AllenNeuralDynamics/harp.device.PhotodiodeBoard/hardware/board/0374 Production Board/0374 Production Board.csv

Reference | Qty | Footprint | Value | Manufacturer | Manufacturer Number | DNP
C1,C2,C6,C8,C13,C14,C15,C16,C17,C18,C19,C20,C25,C28,C29 | 15 | Capacitor_SMD:C_0402_1005Metric | 100nF | Walson Technology Corporation | 0402B104K160CT
C3,C5 | 2 | Capacitor_SMD:C_0805_2012Metric_Pad1.18x1.45mm_HandSolder | 10pF | KEMET | C0805C100J5RACTU
C4,C21 | 2 | Capacitor_SMD:C_0402_1005Metric | 10nF | Murata Electronics | GRM1555C1E103GE01D
C9,C10,C11,C22 | 4 | Capacitor_SMD:C_0402_1005Metric | 1uF | KYOCERA AVX | KAM05CR71A105KH
C12 | 1 | Capacitor_SMD:C_0805_2012Metric | 10uF | Cal-Chip Electronics, Inc. | GMC21X7R106K25NT
C23 | 1 | Capacitor_SMD:C_0402_1005Metric | 2.2uF | Cal-Chip Electronics, Inc. | GMC04X7R225K10NT
CR1,CR2 | 2 | 0374Library:TO99_BPW20RF_VIS | BPW21R | Vishay Semiconductor Opto Division | BPW21R | DNP
D1,D2 | 2 | Diode_SMD:D_0201_0603Metric | D_TVS | onsemi | ESD8472MUT5G
D3,D4 | 2 | LED_SMD:LED_0603_1608Metric_Pad1.05x0.95mm_HandSolder | LED | SunLED | XZCDGK53W-1VF
D5 | 1 | Diode_SMD:D_SOD-323F | BAT54J | MCC (Micro Commercial Components) | BAT54WS-TP
H1,H2,H3,H4 | 4 | MountingHole:MountingHole_3.2mm_M3_DIN965 | MountingHole
H5,H6 | 2 | MountingHole:MountingHole_2.2mm_M2_DIN965 | MountingHole
J1 | 1 | 0374Library:Connector_3M_MiniClamp_4_37204-1BE0-004PL | Conn_01x04_Pin | 3M | 37204-1BE0-004 PL
J2 | 1 | 0374Library:CUI_SJ-3524-SMT-BE | AudioJack3 |  | SJ-3523-SMT-TR
J3 | 1 | Connector_USB:USB_C_Receptacle_JAE_DX07S016JA1R1500 | USB_C_Receptacle_USB2.0 | JAE Electronics | DX07S016JA1R1500
J4,J5 | 2 | Connector_PinHeader_2.54mm:PinHeader_1x03_P2.54mm_Vertical | ~
R1 | 1 | Resistor_SMD:R_0402_1005Metric | 1K | Yageo | AC0402FR-131KL
R2,R3 | 2 | Resistor_SMD:R_0402_1005Metric | 5K1 | Yageo | RT0402FRE075K1L
R4 | 1 | Resistor_SMD:R_0402_1005Metric | 487 | Vishay Dale | CRCW0402487RFKED
R5 | 1 | Resistor_SMD:R_0402_1005Metric | 4.7k | YAGEO | RC0402JR-074K7L
R6,R7 | 2 | Resistor_SMD:R_0805_2012Metric_Pad1.20x1.40mm_HandSolder | 390k
R8 | 1 | Resistor_SMD:R_0402_1005Metric | 10K | KOA Speer Electronics, Inc. | SG73P1EWTTP1002F
R9,R10 | 2 | Resistor_SMD:R_0402_1005Metric | 27 | Yageo | RC0402FR-0727RL
R11,R12 | 2 | Resistor_SMD:R_0402_1005Metric | 330 | Panasonic Electronic Components | ERA-2AEB331X
SW2 | 1 | 0374Library:435451019820 | ~ | Würth Elektronik | 435451019820
TP1,TP2,TP3 | 3 | TestPoint:TestPoint_Loop_D2.50mm_Drill1.0mm | TestPoint
U1 | 1 | Package_TO_SOT_SMD:Texas_DRT-3 | TPD2EUSB30 | Texas Instruments | TPD2EUSB30DRTR
U2 | 1 | Package_TO_SOT_SMD:SOT-23-5 | LP2985-3.3 | Texas Instruments | LP2985-33DBVR
U3 | 1 | 0374Library:QFN56_7X7_RPI | RP2040 | Raspberry Pi | SC0914(13)
U4 | 1 | 0374Library:USON-8_UX_2x3x0p6_WIN | W25Q16JVUXIQ | Winbond Electronics | W25Q16JVUXIQ TR
U5 | 1 | 0374Library:R_8_ADI | AD8656 | Analog Devices Inc. | AD8656ARZ-REEL
U6 | 1 | 0374Library:DDC0005A_M | REF2033AIDDCR | Texas Instruments | REF2033AIDDCR
U7 | 1 | Package_SO:MFSOP6-4_4.4x3.6mm_P1.27mm | Optocoupler_DC_PhotoNPN_AKEC | Lite-On Inc. | LTV-356T
X1 | 1 | Crystal:Crystal_SMD_2016-4Pin_2.0x1.6mm | ECS-TXO-2016 | ECS Inc. | ECS-TXO-2016-33-120-TR
