AllenNeuralDynamics/harp.device.PhotodiodeBoard/hardware/board/Footprint and Symbols/AD8656ARZ_REEL/R_8_ADI.step

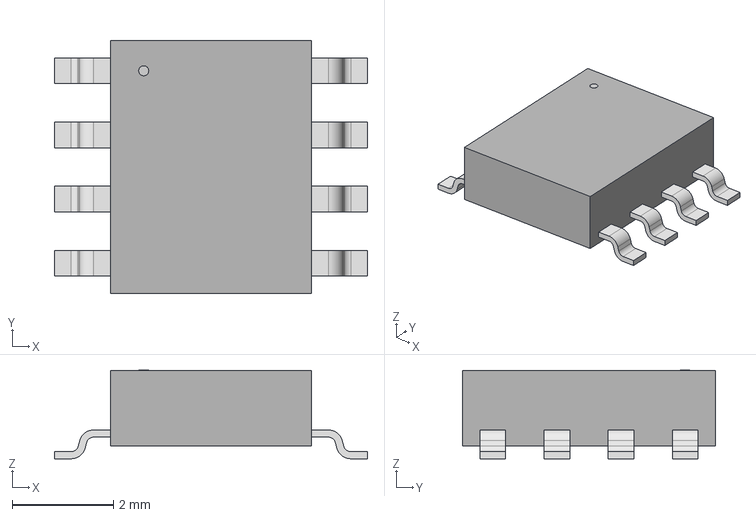
[picture p1: CAD file, 2026-10-02]
hardware/board/Footprint and Symbols/AD8656ARZ_REEL/R_8_ADI.step
6.20 x 5.00 x 1.75 mm
