AllenNeuralDynamics/harp.device.PhotodiodeBoard/hardware/board/Footprint and Symbols/BPW21R/TO99_BPW20RF_VIS.step

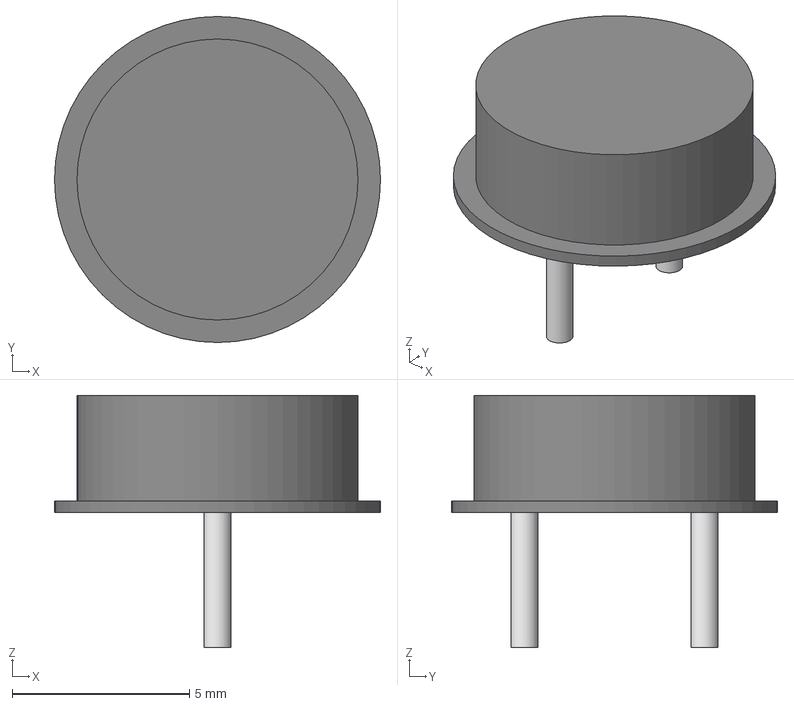
[picture p2: CAD file, 2026-10-02]
hardware/board/Footprint and Symbols/BPW21R/TO99_BPW20RF_VIS.step
9.19 x 9.19 x 7.11 mm
