AllenNeuralDynamics/harp.device.PhotodiodeBoard/hardware/board/Footprint and Symbols/SC0914_13_/QFN56_7X7_RPI.step

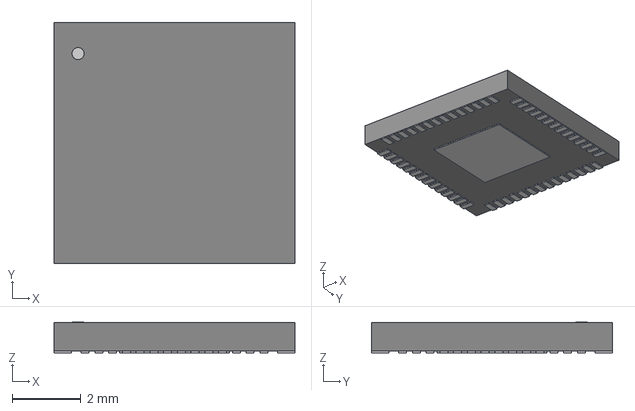
[picture p3: CAD file, 2026-10-02]
hardware/board/Footprint and Symbols/SC0914_13_/QFN56_7X7_RPI.step
7.01 x 7.01 x 0.892 mm
