AllenNeuralDynamics/harp.device.PhotodiodeBoard/hardware/board/Footprint and Symbols/SJ-3524-SMT-BE/SJ-3524-SMT-BE.step

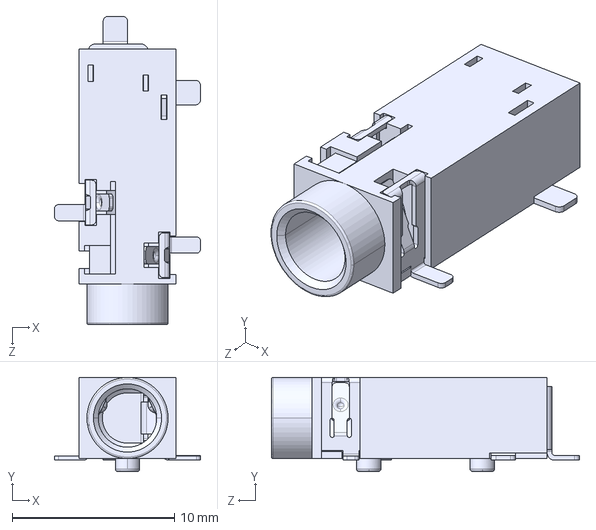
[picture p4: CAD file, 2026-10-02]
hardware/board/Footprint and Symbols/SJ-3524-SMT-BE/SJ-3524-SMT-BE.step
9.00 x 5.80 x 19.0 mm
