AllenNeuralDynamics/harp.device.PhotodiodeBoard/hardware/board/Footprint and Symbols/W25Q16JVUXIQ_TR/USON-8_UX_2x3x0p6_WIN.step

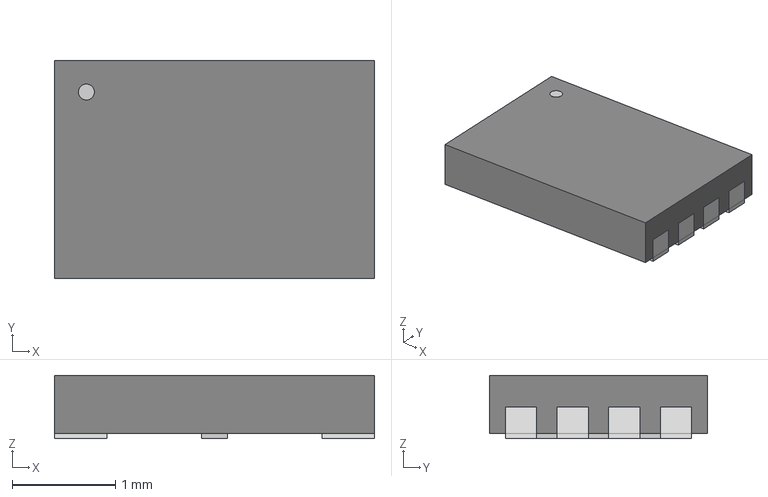
[picture p5: CAD file, 2026-10-02]
hardware/board/Footprint and Symbols/W25Q16JVUXIQ_TR/USON-8_UX_2x3x0p6_WIN.step
3.10 x 2.11 x 0.612 mm
