AllenNeuralDynamics/harp.device.PhotodiodeBoard/(list of files, cad)

Other CAD files:
hardware/board/Footprint and Symbols/435451019820/435451019820.step
