AllenNeuralDynamics/harp.device.PhotodiodeBoard/hardware/board/0374 Production Board/0374 Production Board.kicad_pcb

## KiCad design hardware/board/0374 Production Board/0374 Production Board.kicad_pcb (2026-10-02)

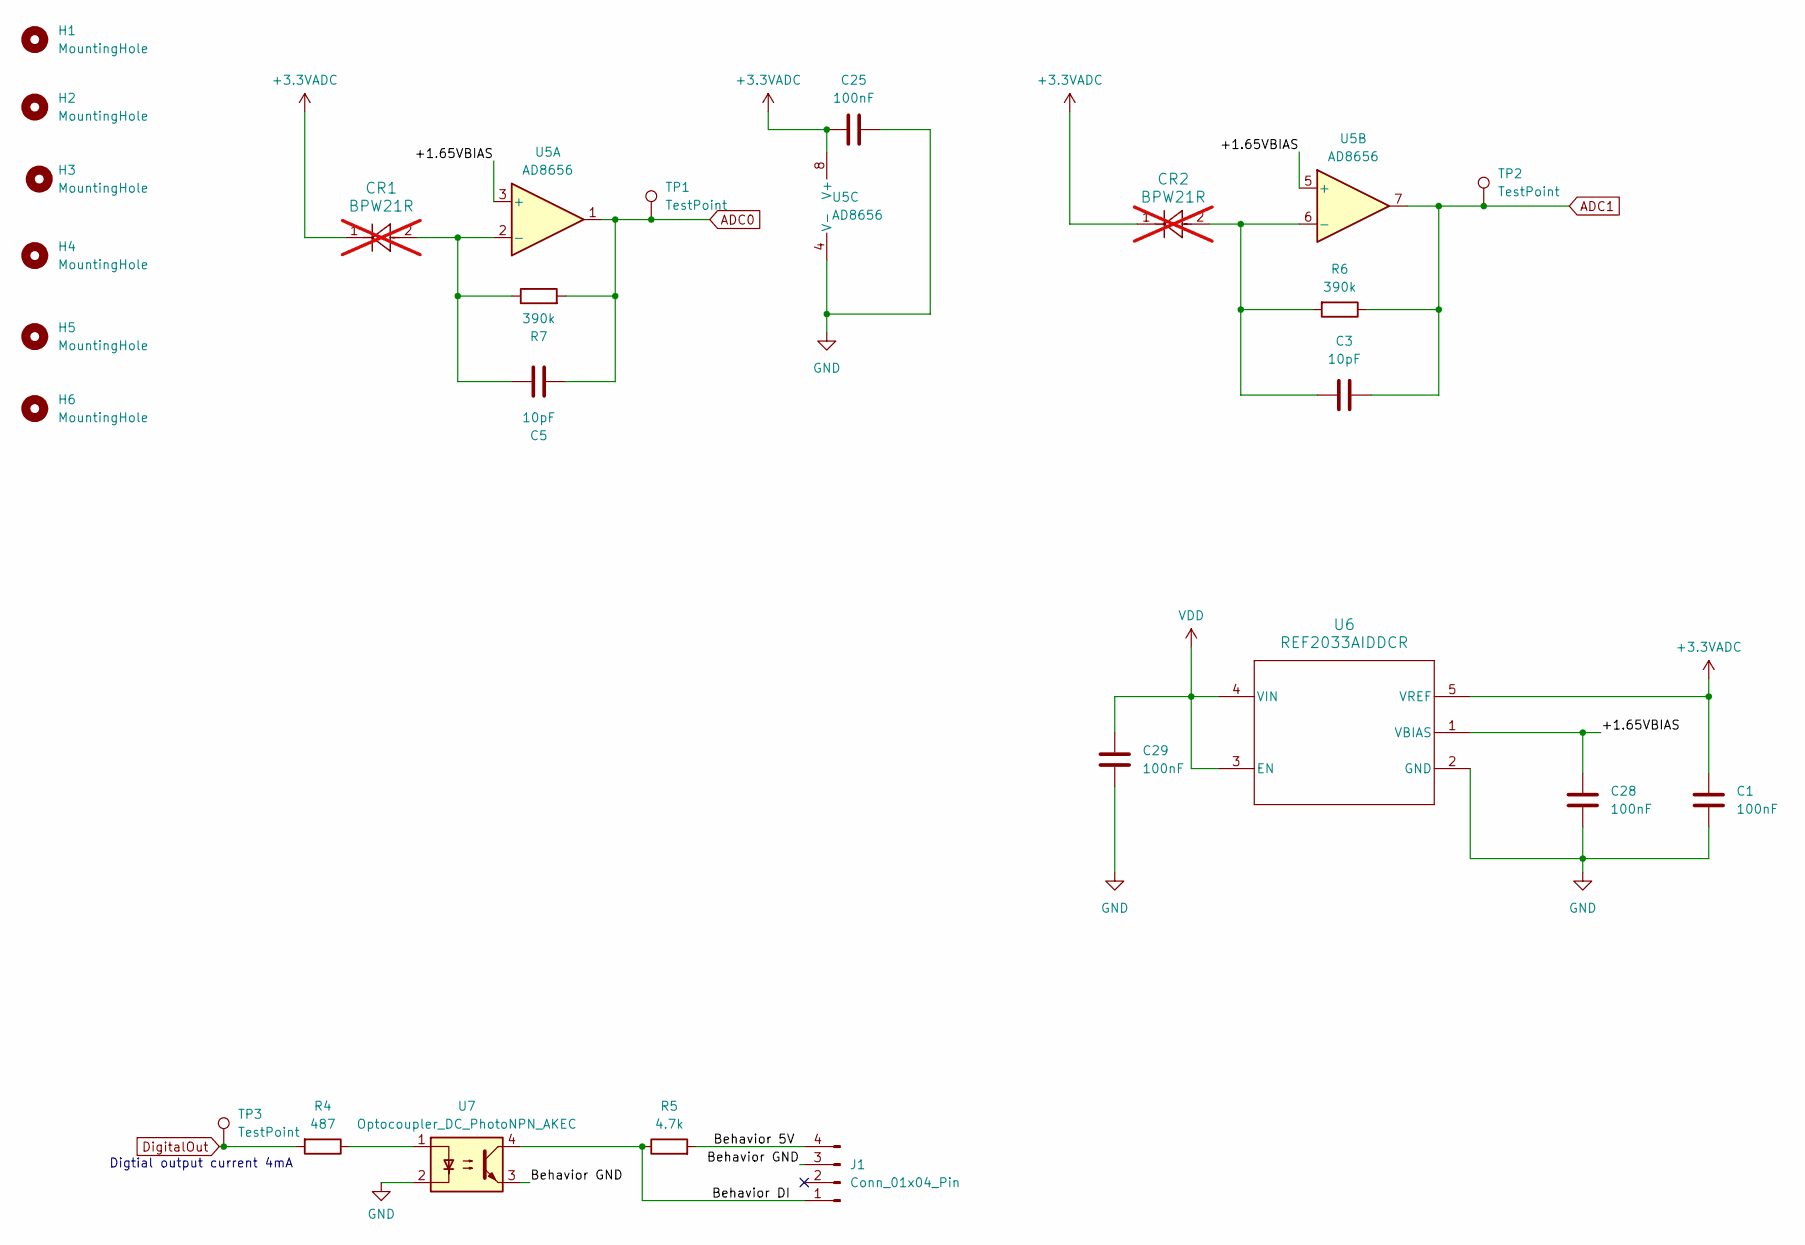
[picture p6: schematic 0374_Photodiode.kicad_sch]

Parts:
C1, C25, C28, C29: 100nF; C_0402_1005Metric; Rated Voltage 16V; Tolerance 10%
C3, C5: 10pF; C_0805_2012Metric_Pad1.18x1.45mm_HandSolder; Rated Voltage 50V; Tolerance 5%
CR1, CR2: BPW21R; TO99_BPW20RF_VIS; not fitted
H1, H2, H3, H4: MountingHole; MountingHole_3.2mm_M3_DIN965
H5, H6: MountingHole; MountingHole_2.2mm_M2_DIN965
J1: Conn_01x04_Pin; Connector_3M_MiniClamp_4_37204-1BE0-004PL
R4: 487; R_0402_1005Metric
R5: 4.7k; R_0402_1005Metric
R6, R7: 390k; R_0805_2012Metric_Pad1.20x1.40mm_HandSolder
TP1, TP2, TP3: TestPoint; TestPoint_Loop_D2.50mm_Drill1.0mm
U5: AD8656; R_8_ADI
U6: REF2033AIDDCR; DDC0005A_M
U7: Optocoupler_DC_PhotoNPN_AKEC; MFSOP6-4_4.4x3.6mm_P1.27mm

Connections:
+3.3VADC: C1.1, C25.1, CR1.1, CR2.1, U5.8 (V+), U6.5 (VREF); also elsewhere on the board
/PD with OP AMP + DO connection/+1.65VBIAS: C28.1, U5.3 (+), U5.5 (+), U6.1 (VBIAS)
/PD with OP AMP + DO connection/Behavior 5V: J1.4, R5.2
/PD with OP AMP + DO connection/Behavior DI: J1.1, R5.1, U7.4
/PD with OP AMP + DO connection/Behavior GND: J1.3, U7.3
ADC0: C5.1, R7.2, TP1.1, U5.1; also elsewhere on the board
ADC1: C3.1, R6.1, TP2.1, U5.7; also elsewhere on the board
DigitalOut: R4.2, TP3.1; also elsewhere on the board
GND: C1.2, C25.2, C28.2, C29.2, U5.4 (V-), U6.2 (GND), U7.2; also elsewhere on the board
unnamed: R4.1, U7.1
unnamed: C5.2, CR1.2, R7.1, U5.2 (-)
unnamed: C3.2, CR2.2, R6.2, U5.6 (-)
VDD: C29.1, U6.3 (EN), U6.4 (VIN); also elsewhere on the board

Notes on the sheet:
Digtial output current 4mA

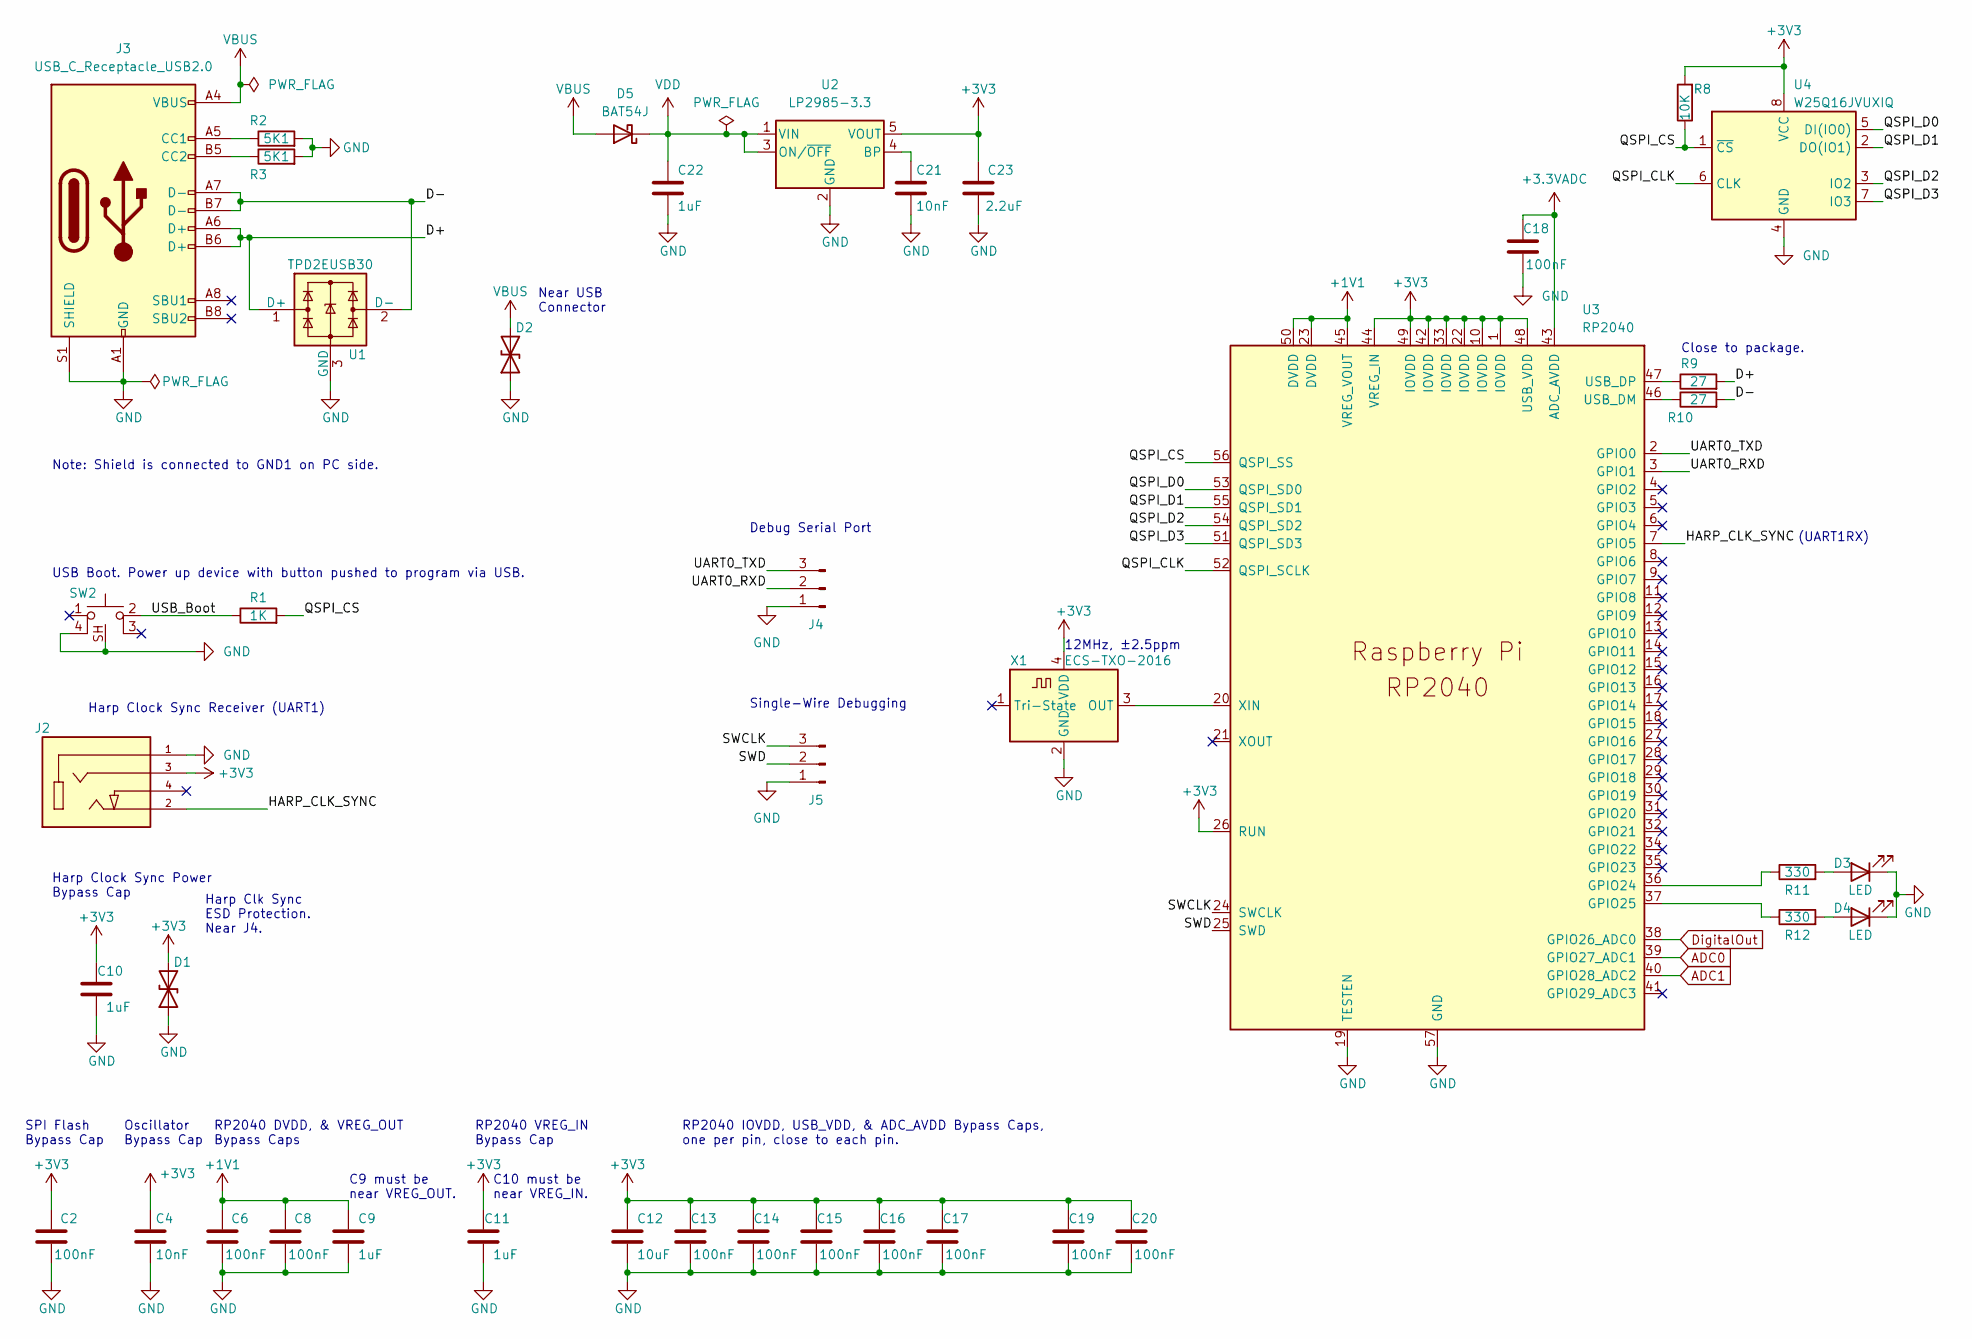
[picture p7: schematic rp2040_with_usb.kicad_sch]

Parts:
C2, C6, C8, C13, C14, C15, C16, C17, C18, C19, C20: 100nF; C_0402_1005Metric; Rated Voltage 16V; Tolerance 10%
C4, C21: 10nF; C_0402_1005Metric; Rated Voltage 25V; Tolerance 2%
C9, C10, C11, C22: 1uF; C_0402_1005Metric; Rated Voltage 10V; Tolerance 10%
C12: 10uF; C_0805_2012Metric; Rated Voltage 25V; Tolerance 10%
C23: 2.2uF; C_0402_1005Metric; Rated Voltage 10V; Tolerance 10%
D1, D2: D_TVS; D_0201_0603Metric
D3, D4: LED; LED_0603_1608Metric_Pad1.05x0.95mm_HandSolder
D5: BAT54J; D_SOD-323F
J2: AudioJack3; CUI_SJ-3524-SMT-BE
J3: USB_C_Receptacle_USB2.0; USB_C_Receptacle_JAE_DX07S016JA1R1500
J4, J5: PinHeader_1x03_P2.54mm_Vertical
R1: 1K; R_0402_1005Metric; Tolerance 1%
R2, R3: 5K1; R_0402_1005Metric; Tolerance 1%
R8: 10K; R_0402_1005Metric; Tolerance 1%
R9, R10: 27; R_0402_1005Metric; Tolerance 1%
R11, R12: 330; R_0402_1005Metric; Tolerance 0.1%
SW2: 435451019820
U1: TPD2EUSB30; Texas_DRT-3
U2: LP2985-3.3; SOT-23-5
U3: RP2040; QFN56_7X7_RPI
U4: W25Q16JVUXIQ; USON-8_UX_2x3x0p6_WIN
X1: ECS-TXO-2016; Crystal_SMD_2016-4Pin_2.0x1.6mm; Tolerance ±2.5ppm

Connections:
+1V1: C6.2, C8.2, C9.1, U3.23 (DVDD), U3.45 (VREG_VOUT), U3.50 (DVDD)
+3.3VADC: C18.2, U3.43 (ADC_AVDD); also elsewhere on the board
+3V3: C2.2, C4.1, C10.1, C11.1, C12.1, C13.2, C14.2, C15.2, C16.2, C17.2, C19.2, C20.2, C23.2, D1.2 (A2), J2.3, R8.2, U2.5 (VOUT), U3.1 (IOVDD), U3.10 (IOVDD), U3.22 (IOVDD), U3.26 (RUN), U3.33 (IOVDD), U3.42 (IOVDD), U3.44 (VREG_IN), U3.48 (USB_VDD), U3.49 (IOVDD), U4.8 (VCC), X1.4 (VDD)
/Harp Core RP2040 + USB/D+: J3.A6 (D+), J3.B6 (D+), R9.2, U1.1 (D+)
/Harp Core RP2040 + USB/D-: J3.A7 (D-), J3.B7 (D-), R10.2, U1.2 (D-)
/Harp Core RP2040 + USB/HARP_CLK_SYNC: J2.2, U3.7 (GPIO5)
/Harp Core RP2040 + USB/QSPI_CLK: U3.52 (QSPI_SCLK), U4.6 (CLK)
/Harp Core RP2040 + USB/QSPI_CS: R1.2, R8.1, U3.56 (QSPI_SS), U4.1 (~CS)
/Harp Core RP2040 + USB/QSPI_D0: U3.53 (QSPI_SD0), U4.5 (DI(IO0))
/Harp Core RP2040 + USB/QSPI_D1: U3.55 (QSPI_SD1), U4.2 (DO(IO1))
/Harp Core RP2040 + USB/QSPI_D2: U3.54 (QSPI_SD2), U4.3 (IO2)
/Harp Core RP2040 + USB/QSPI_D3: U3.51 (QSPI_SD3), U4.7 (IO3)
/Harp Core RP2040 + USB/SWCLK: J5.3, U3.24 (SWCLK)
/Harp Core RP2040 + USB/SWD: J5.2, U3.25 (SWD)
/Harp Core RP2040 + USB/UART0_RXD: J4.2, U3.3 (GPIO1)
/Harp Core RP2040 + USB/UART0_TXD: J4.3, U3.2 (GPIO0)
/Harp Core RP2040 + USB/USB_Boot: R1.1, SW2.2
ADC0: U3.39 (GPIO27_ADC1); also elsewhere on the board
ADC1: U3.40 (GPIO28_ADC2); also elsewhere on the board
DigitalOut: U3.38 (GPIO26_ADC0); also elsewhere on the board
GND: C2.1, C4.2, C6.1, C8.1, C9.2, C10.2, C11.2, C12.2, C13.1, C14.1, C15.1, C16.1, C17.1, C18.1, C19.1, C20.1, C21.2, C22.2, C23.1, D1.1 (A1), D2.1 (A1), D3.1 (K), D4.1 (K), J2.1, J3.A1 (GND), J3.A12 (GND), J3.B1 (GND), J3.B12 (GND), J3.S1 (SHIELD), J4.1, J5.1, R2.2, R3.2, SW2.4, SW2.SH, U1.3 (GND), U2.2 (GND), U3.19 (TESTEN), U3.57 (GND), U4.4 (GND), X1.2 (GND); also elsewhere on the board
unnamed: D3.2 (A), R11.2
unnamed: D4.2 (A), R12.2
unnamed: J3.A5 (CC1), R2.1
unnamed: J3.B5 (CC2), R3.1
unnamed: C21.1, U2.4 (BP)
unnamed: R11.1, U3.36 (GPIO24)
unnamed: R12.1, U3.37 (GPIO25)
unnamed: R10.1, U3.46 (USB_DM)
unnamed: R9.1, U3.47 (USB_DP)
unnamed: U3.20 (XIN), X1.3 (OUT)
VBUS: D2.2 (A2), D5.2 (A), J3.A4 (VBUS), J3.A9 (VBUS), J3.B4 (VBUS), J3.B9 (VBUS)
VDD: C22.1, D5.1 (K), U2.1 (VIN), U2.3 (ON/~OFF); also elsewhere on the board

Notes on the sheet:
C10 must be near VREG_IN.
C9 must be near VREG_OUT.
SPI Flash Bypass Cap
Close to package.
Harp Clock Sync Power Bypass Cap
Harp Clock Sync Receiver (UART1)
Oscillator Bypass Cap
RP2040 DVDD, & VREG_OUT Bypass Caps
RP2040 VREG_IN Bypass Cap
USB Boot. Power up device with button pushed to program via USB.
(UART1RX)
RP2040 IOVDD, USB_VDD, & ADC_AVDD Bypass Caps, one per pin, close to each pin.
Near USB Connector
Note: Shield is connected to GND1 on PC side.
12MHz, ±2.5ppm
Harp Clk Sync ESD Protection. Near J4.
Debug Serial Port
Single-Wire Debugging

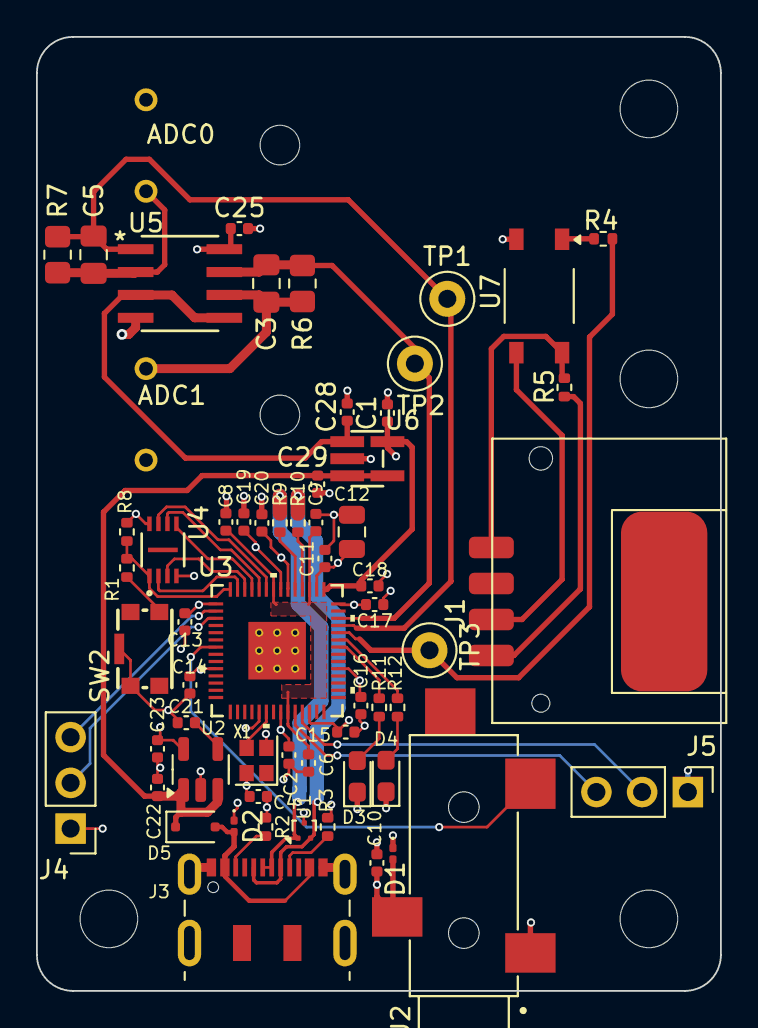
[picture p8: board 0374 Production Board.kicad_pcb from above]

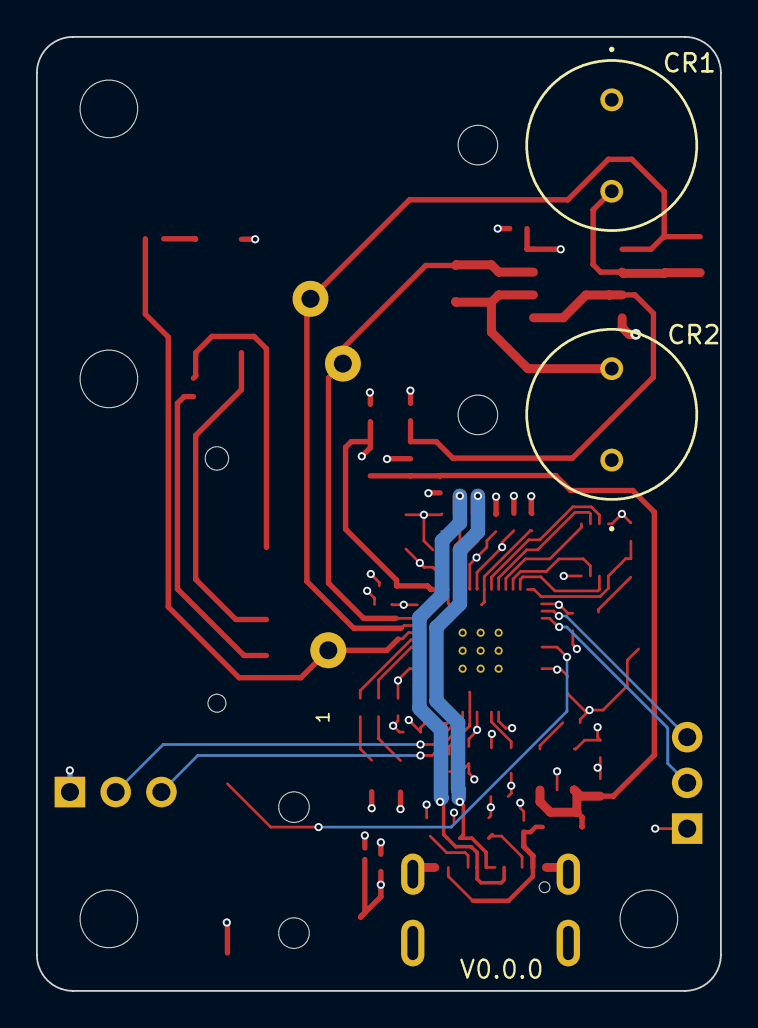
[picture p9: board 0374 Production Board.kicad_pcb from below]

Board: 4 copper layers, 38.0 x 53.0 mm, 67 parts (2 on the bottom side), 40 nets.
