AllenNeuralDynamics/harp.device.PhotodiodeBoard/hardware/board/usb_isolated/usb_isolated.kicad_pcb

## KiCad design hardware/board/usb_isolated/usb_isolated.kicad_pcb (2025-06-09)

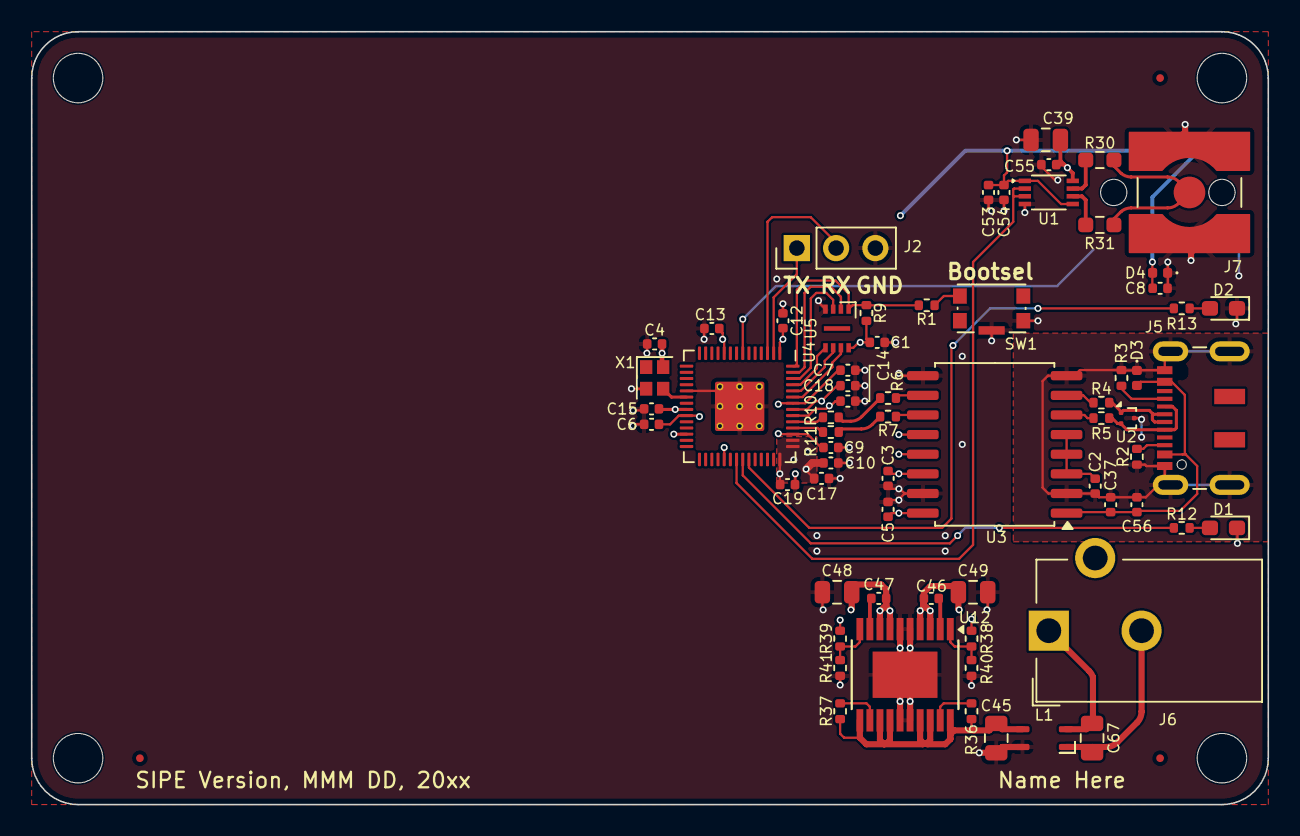
[picture p10: board usb_isolated.kicad_pcb from above]

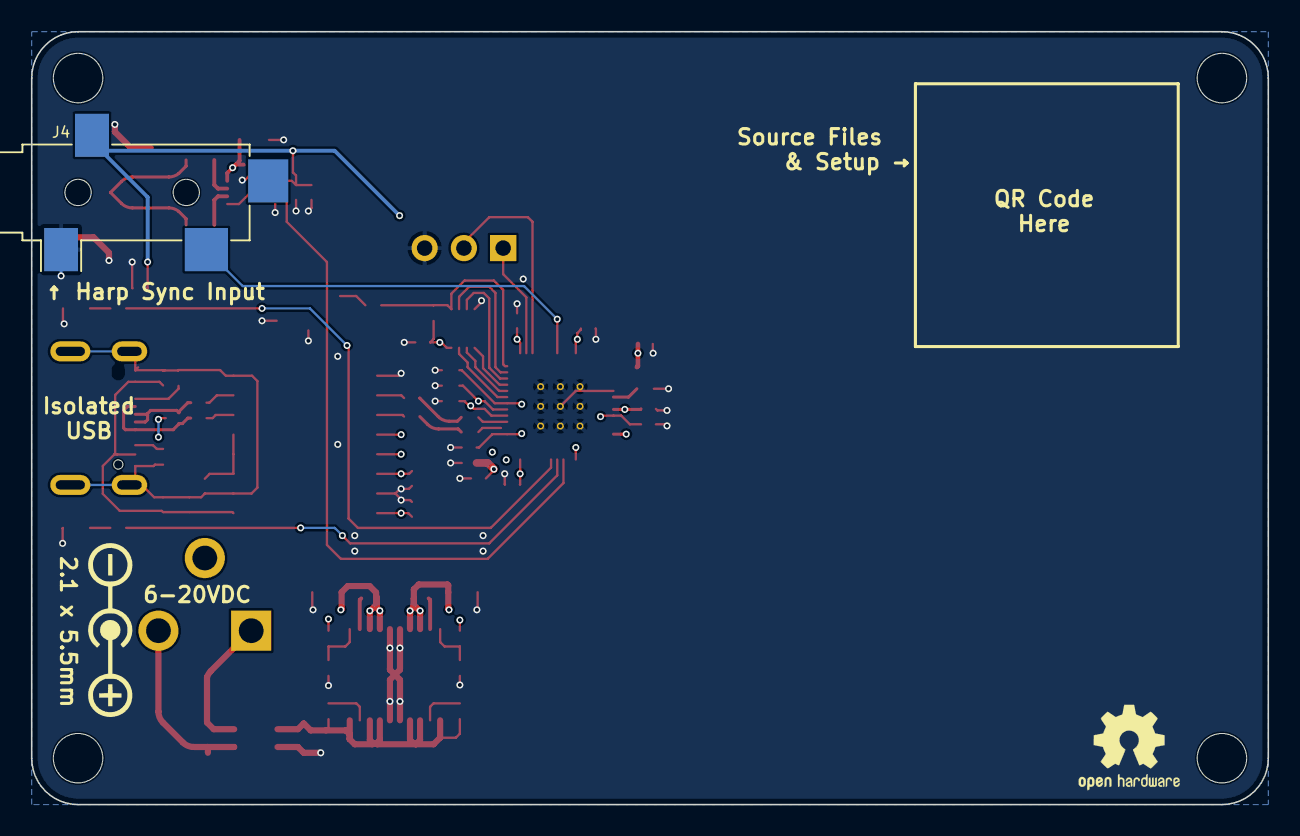
[picture p11: board usb_isolated.kicad_pcb from below]

Board: 4 copper layers, 80.0 x 50.0 mm, 72 parts (3 on the bottom side), 47 nets.

Parts:
C1, C2, C3, C5, C6, C7, C12, C13, C14, C15, C17, C18, C19, C37, C54, C55: 100nF; C_0402_1005Metric
C4, C46, C47: 10nF; C_0402_1005Metric
C8, C9, C10, C53, C56: 1uF; C_0402_1005Metric
C39, C48: 10uF; C_0805_2012Metric
C45, C67: 3.3uF; C_0805_2012Metric
C49: 22uF; C_0805_2012Metric
D1, D2: LED; LED_0603_1608Metric_Pad1.05x0.95mm_HandSolder
D3, D4: D_TVS; D_0402_1005Metric
FID1, FID2, FID3: Fiducial; Fiducial_0.5mm_Mask1mm
G3: LOGO
J2: Conn_01x03_Male; PinHeader_1x03_P2.54mm_Vertical
J4: AudioJack3; Jack_3.5mm_CUI_SJ-3524-SMT_Horizontal
J5: USB_C_Receptacle_USB2.0; USB_C_Receptacle_JAE_DX07S016JA1R1500
J6: Barrel_Jack_Switch; BarrelJack_CUI_PJ-102AH_Horizontal
J7: Conn_Coaxial; SMA_TE_Connectivity_CONSMA002-SMD-G-T_Horizontal
L1: L_Coupled_1423; L_CommonModeChoke_TDKCorporation_1210
R1: 1K; R_0402_1005Metric
R2, R3: 5K1; R_0402_1005Metric
R4, R5, R6, R7: 24; R_0402_1005Metric
R9: 10K; R_0402_1005Metric
R10, R11: 27; R_0402_1005Metric
R12, R13: 680; R_0402_1005Metric
R30, R31: 100; R_0603_1608Metric_Pad0.98x0.95mm_HandSolder
R36, R37: 1M; R_0402_1005Metric
R38: 309K; R_0402_1005Metric
R39: 172K; R_0402_1005Metric
R40, R41: 100K; R_0402_1005Metric
REF1: OSHW-Logo2_7.3x6mm_SilkScreen
SW1: SW_Push_1P1T-SH_NO_Vertical_Wuerth_WS-TASV
U1: 74LVCH2T45DC; VSSOP-8_2.3x2mm_P0.5mm
U2: TPD2EUSB30; Texas_DRT-3
U3: ADUM4160; SOIC-16W_7.5x10.3mm_P1.27mm
U4: RP2040; RP2040-QFN-56
U5: W25Q16JVUXIQ; Winbond-8USON-2x3mm
U12: LT3030; ETSSOP-20-1EP_4.4x6.5mm_P0.65mm_EP3x4.2mm
X1: ECS-TXO-2016; Crystal_SMD_2016-4Pin_2.0x1.6mm

Connections:
+1V1: C6.2, C7.2, C9.1, U4.23 (DVDD), U4.45 (VREG_VOUT), U4.50 (DVDD)
+3.3V: C1.2, C3.2, C4.2, C5.2, C8.1, C10.1, C12.2, C13.2, C14.2, C15.2, C17.2, C18.2, C19.2, C47.1, C48.1, C53.1, C54.2, D4.2 (A2), J4.R, R9.2, R39.1, U1.1 (VCCA), U1.5 (DIR), U3.12 (PIN), U3.13 (SPD), U3.14 (VDD2), U3.16 (VBUS2), U4.1 (IOVDD), U4.10 (IOVDD), U4.22 (IOVDD), U4.26 (RUN), U4.33 (IOVDD), U4.42 (IOVDD), U4.43 (ADC_AVDD), U4.44 (VREG_IN), U4.48 (USB_VDD), U4.49 (IOVDD), U5.8 (VCC), U12.7 (OUT2), U12.8 (OUT2), X1.4 (VDD)
+5V: C39.1, C46.1, C49.1, C55.2, R38.1, U1.8 (VCCB), U12.3 (OUT1), U12.4 (OUT1)
+12V: C67.1, J6.1, L1.2
/Harp Core RP2040 + Isolated USB/D+: J5.A6 (D+), J5.B6 (D+), R4.1, U2.1 (D+)
/Harp Core RP2040 + Isolated USB/D-: J5.A7 (D-), J5.B7 (D-), R5.1, U2.2 (D-)
/Harp Core RP2040 + Isolated USB/DD+: R6.2, R10.2
/Harp Core RP2040 + Isolated USB/DD-: R7.2, R11.2
/Harp Core RP2040 + Isolated USB/HARP_CLK_SYNC: J4.T, U4.7 (GPIO5)
/Harp Core RP2040 + Isolated USB/QSPI_CLK: U4.52 (QSPI_SCLK), U5.6 (CLK)
/Harp Core RP2040 + Isolated USB/QSPI_CS: R1.2, R9.1, U4.56 (QSPI_SS), U5.1 (~CS)
/Harp Core RP2040 + Isolated USB/QSPI_D0: U4.53 (QSPI_SD0), U5.5 (DI(IO0))
/Harp Core RP2040 + Isolated USB/QSPI_D1: U4.55 (QSPI_SD1), U5.2 (DO(IO1))
/Harp Core RP2040 + Isolated USB/QSPI_D2: U4.54 (QSPI_SD2), U5.3 (IO2)
/Harp Core RP2040 + Isolated USB/QSPI_D3: U4.51 (QSPI_SD3), U5.7 (IO3)
/Harp Core RP2040 + Isolated USB/TTL_OUT: U1.2 (1A), U1.3 (2A), U4.35 (GPIO23)
/Harp Core RP2040 + Isolated USB/UART0_RXD: J2.2, U4.3 (GPIO1)
/Harp Core RP2040 + Isolated USB/UART0_TXD: J2.1, U4.2 (GPIO0)
/Harp Core RP2040 + Isolated USB/USB_Boot: R1.1, SW1.2
/Harp Core RP2040 + Isolated USB/VDD1: C2.2, U3.3 (VDD1), U3.4 (PDEN), U3.5 (SPU)
GND: C1.1, C3.1, C4.1, C5.1, C6.1, C7.1, C8.2, C9.2, C10.2, C12.1, C13.1, C14.1, C15.1, C17.1, C18.1, C19.1, C39.2, C45.2, C48.2, C49.2, C53.2, C54.1, C55.1, D1.1 (K), D2.1 (K), D4.1 (A1), J2.3, J4.S, J7.2 (Ext), L1.4, R40.1, R41.1, SW1.4, SW1.SH, U1.4 (GND), U3.9 (GND2), U3.15 (GND2), U4.19 (TESTEN), U4.57 (GND), U5.4 (GND), U12.5 (GND), U12.6 (GND), U12.15 (GND), U12.16 (GND), U12.21 (GND), X1.2 (GND)
GND1: C2.1, C37.1, C56.2, D3.1 (A1), J5.A1 (GND), J5.A12 (GND), J5.B1 (GND), J5.B12 (GND), J5.S1 (SHIELD), R2.2, R3.2, U2.3 (GND), U3.2 (GND1), U3.8 (GND1)
GND2: C67.2, J6.2, L1.1
IN1: C45.1, L1.3, R36.1, R37.1, U12.11 (~SHDN2), U12.13 (IN2), U12.14 (IN2), U12.17 (IN1), U12.18 (IN1), U12.20 (~SHDN1)
unnamed: D1.2 (A), R12.2
unnamed: D2.2 (A), R13.2
unnamed: J5.A5 (CC1), R2.1
unnamed: J5.B5 (CC2), R3.1
unnamed: J7.1 (In), R30.2, R31.2
unnamed: R30.1, U1.7 (1B)
unnamed: R31.1, U1.6 (2B)
unnamed: R6.1, U3.10 (DD+)
unnamed: R7.1, U3.11 (DD-)
unnamed: R4.2, U3.7 (UD+)
unnamed: R5.2, U3.6 (UD-)
unnamed: R12.1, U4.36 (GPIO24)
unnamed: R13.1, U4.37 (GPIO25)
unnamed: R11.1, U4.46 (USB_DM)
unnamed: R10.1, U4.47 (USB_DP)
unnamed: U4.20 (XIN), X1.3 (OUT)
unnamed: R38.2, R40.2, U12.1 (ADJ1)
unnamed: R39.2, R41.2, U12.10 (ADJ2)
unnamed: C46.2, U12.2 (BYP1)
unnamed: C47.2, U12.9 (BYP2)
unnamed: R36.2, U12.19 (PWRGD1)
unnamed: R37.2, U12.12 (PWRGD2)
VBUS: C37.2, C56.1, D3.2 (A2), J5.A4 (VBUS), J5.A9 (VBUS), J5.B4 (VBUS), J5.B9 (VBUS), U3.1 (VBUS1)
