AllenNeuralDynamics/harp.device.PhotodiodeBoard/device.yml

device: PhotodiodeBoard
whoAmI: 1412
firmwareVersion: "0.0.0"
hardwareTargets: "0.0.0"
registers:
  ADC:
    address: 32
    type: U8
    length: 2
    access: Event
    description: Raw photodiode ADC readings for ADC0 and ADC1 (top 8 bits of the 12-bit conversion).
    payloadSpec:
      ADC0:
        offset: 0
        description: Raw counts of ADC channel 0 (0-255).
      ADC1:
        offset: 1
        description: Raw counts of ADC channel 1 (0-255).
